Galacs/s6tm-detect-psu-1/s6tm-detect-psu-1.kicad_pcb

## KiCad design s6tm-detect-psu-1.kicad_pcb (2026-09-20)

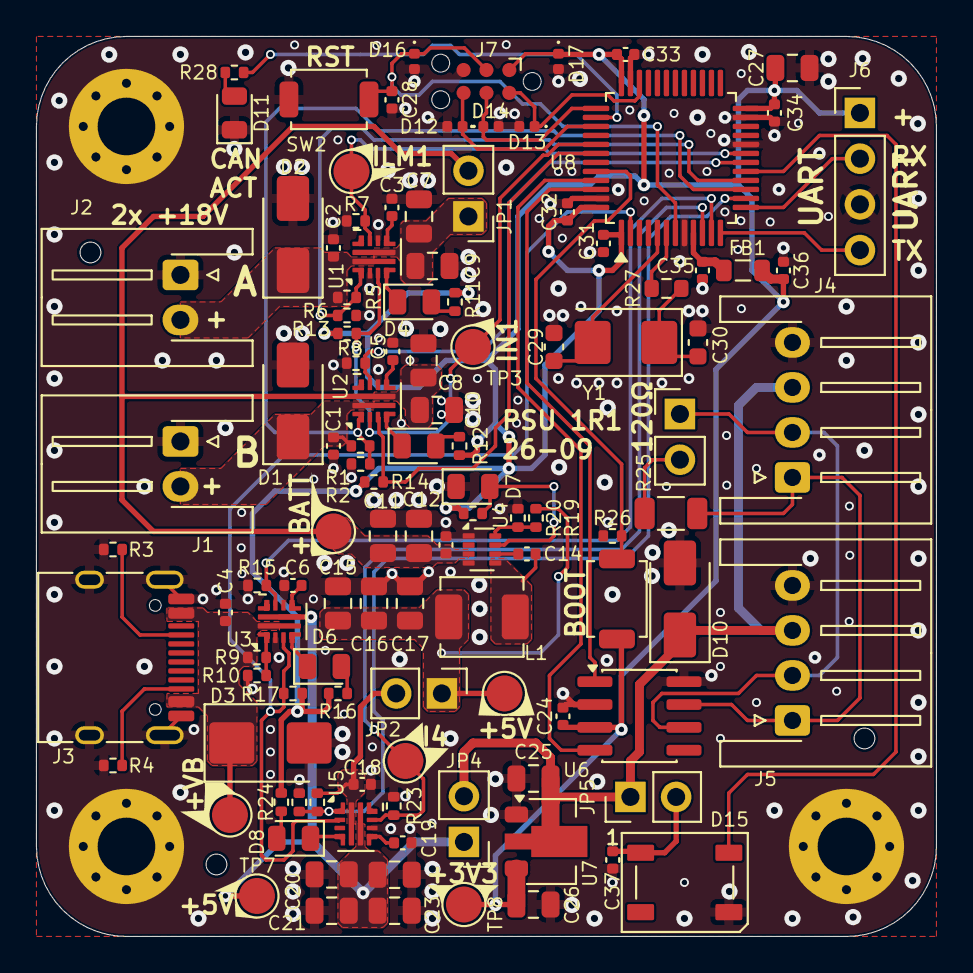
[picture p1: board s6tm-detect-psu-1.kicad_pcb from above]

Board: 4 copper layers, 50.0 x 50.0 mm, 120 parts (0 on the bottom side), 56 nets.

Parts:
C1, C2, C4, C18, C35, C36, C37: 1u; C_0402_1005Metric
C3, C5, C6, C19: 1n; C_0402_1005Metric
C7, C8, C9, C10, C11, C12, C15, C16, C17, C20, C21, C22, C23, C25, C26, C27: 10u; C_0805_2012Metric
C13, C14, C24, C28, C31, C32, C33, C34: 0u1; C_0402_1005Metric
C29, C30: 20p; C_0603_1608Metric
D1, D2, D10: SMBJ6.0CA; D_SMA
D3: SMBJ6.0CA; D_SMB
D4, D5, D6, D8: GREEN; LED_0805_2012Metric
D7: RED; LED_0805_2012Metric
D11: YELLOW; LED_0805_2012Metric
D12, D13, D14, D16, D17: H5VU10U; Diode_DFN1006
D15: WS2812B; LED_WS2812B_PLCC4_5.0x5.0mm_P3.2mm
FB1: 600Ω@100M; L_0805_2012Metric
H1, H2, H3: MountingHole; ToolingHole_1.152mm
H6, H7, H8: MountingHole_Pad; MountingHole_3.2mm_M3_Pad_Via
J1, J2: Conn_01x02; JST_XH_S2B-XH-A-1_1x02_P2.50mm_Horizontal
J3: USB_C_Receptacle_USB2.0_14P; USB_C_Receptacle_HRO_TYPE-C-31-M-12
J4, J5: Conn_01x04; JST_XH_S4B-XH-A-1_1x04_P2.50mm_Horizontal
J6: Conn_01x04_Pin; PinHeader_1x04_P2.54mm_Vertical
J7: TC2030; Tag-Connect_TC2030-IDC-NL_2x03_P1.27mm_Vertical
JP1, JP2, JP3, JP4, JP5: Jumper_2_Small_Bridged; PinHeader_1x02_P2.54mm_Vertical
L1: 3u3; L_Sunlord_MWSA0402S
R1, R5, R9, R13, R14, R17, R20, R21, R26: 10k; R_0402_1005Metric
R2, R6, R15, R23: 1k; R_0402_1005Metric
R3, R4, R11, R12, R16, R18, R24, R28: 5k1; R_0402_1005Metric
R7, R8, R10, R22: 3k3; R_0402_1005Metric
R19: 52k3; R_0402_1005Metric
R25: 120; R_1206_3216Metric
R27: 560; R_0603_1608Metric
SW1, SW2: SW_Push; SW_SPST_TS-1088-xR020
TP1, TP2, TP3, TP4, TP5, TP6, TP7, TP8: TestPoint; TestPoint_Pad_D2.0mm
U1, U2, U3, U5: TPS259470x; Texas_RPW0010A_VQFN-HR-10_2x2mm_P0.5mm
U4: TPS62933; SOT-583-8
U6: SN65HVD230; SOIC-8_3.9x4.9mm_P1.27mm
U7: HT753-1; SOT-89-3
U8: STM32F103C8Tx; LQFP-48_7x7mm_P0.5mm
Y1: 8M; Crystal_SMD_5032-2Pin_5.0x3.2mm

Connections:
5_V: R21.1, R22.2, U5.1 (EN/UVLO), U8.14 (ADC1_IN4)
+3V3: C24.1, C26.1, C27.1, C31.1, C32.1, C33.1, C34.1, C36.1, D17.1 (K), FB1.2, J6.1, J7.1 (VCC), R11.2, R12.2, R13.1, R14.1, R16.2, R17.1, R18.1, R24.2, SW1.1, TP8.1 (1_1), U6.3 (VCC), U7.3 (VOUT), U8.1 (VBAT), U8.24 (VDD), U8.36 (VDD), U8.48 (VDD)
+5V: C20.1, C21.1, C22.1, C23.1, C25.1, C37.2, D10.1 (A1), D15.1 (VDD), J4.3, J5.3, JP4.1 (A), JP4.2 (B), JP5.1 (A), JP5.2 (B), TP7.1 (1_1), U3.6 (OUT), U5.6 (OUT), U7.2 (VIN)
+5V_SMPS: C15.1, C16.1, C17.1, C18.2, JP2.1 (A), JP2.2 (B), L1.2, R19.2, R21.2, TP5.1 (1_1), U5.5 (IN)
+BATT: C7.1, C8.1, C9.1, C10.1, C11.1, C12.1, C13.1, JP1.1 (A), JP1.2 (B), TP4.1 (1_1), U1.6 (OUT), U2.6 (OUT), U4.3 (VIN)
+Vbus: C4.2, D3.1 (A1), J3.A4 (VBUS), J3.A9 (VBUS), J3.B4 (VBUS), J3.B9 (VBUS), R9.2, TP1.1 (1_1), U3.5 (IN)
/Logic/BOOT: R26.2, SW1.2, U8.44 (BOOT0)
/Logic/CANH: J4.1, J5.1, R25.1, U6.7 (CANH)
/Logic/CANL: J4.2, J5.2, JP3.1 (A), U6.6 (CANL)
/Logic/CAN_RX: U6.4 (R), U8.45 (CAN_RX)
/Logic/CAN_TX: U6.1 (D), U8.46 (CAN_TX)
/Logic/NRST: C28.1, D16.1 (K), J7.3 (~RESET), SW2.2, U8.7 (NRST)
/Logic/RGB: D15.4 (DIN), U8.17 (PA7)
/Logic/SWCLK: D14.1 (K), J7.4 (SWCLK), U8.37 (SWCLK)
/Logic/SWDIO: D13.1 (K), J7.2 (SWDIO), U8.34 (SWDIO)
/Logic/SWO: D12.1 (K), J7.6 (SWO), U8.39 (PB3)
/Logic/U0RXD: J6.2, U8.13 (USART2_RX)
/Logic/U0TXD: J6.4, U8.12 (USART2_TX)
/Logic/XTAL_I: C29.1, U8.5 (RCC_OSC_IN), Y1.2
/Logic/XTAL_O: R27.2, U8.6 (RCC_OSC_OUT)
/Logic/XTAL_RO: C30.1, R27.1, Y1.1
BATT1_V: R5.1, R6.2, U1.1 (EN/UVLO), U8.16 (ADC1_IN6)
BATT2_V: R1.1, R2.2, U2.1 (EN/UVLO), U8.15 (ADC1_IN5)
GND: C1.1, C2.1, C3.2, C4.1, C5.2, C6.2, C7.2, C8.2, C9.2, C10.2, C11.2, C12.2, C13.2, C15.2, C16.2, C17.2, C18.1, C19.2, C20.2, C21.2, C22.2, C23.2, C24.2, C25.2, C26.2, C27.2, C28.2, C29.2, C30.2, C31.2, C32.2, C33.2, C34.2, C35.2, C36.2, C37.1, D1.2 (A2), D2.2 (A2), D3.2 (A2), D7.1 (K), D10.2 (A2), D11.1 (K), D12.2 (A), D13.2 (A), D14.2 (A), D15.3 (VSS), D16.2 (A), D17.2 (A), H6.1 (1_1), H7.1 (1_1), H8.1 (1_1), J1.1, J2.1, J3.A1 (GND), J3.A12 (GND), J3.B1 (GND), J3.B12 (GND), J3.SH (SHIELD), J4.4, J5.4, J6.3, J7.5 (GND), R2.1, R3.1, R4.1, R6.1, R7.2, R8.2, R10.1, R15.2, R20.1, R22.1, R23.2, R26.1, SW2.1, U1.2 (OVLO), U1.8 (GND), U2.8 (GND), U3.2 (OVLO), U3.8 (GND), U4.1 (RT), U4.4 (GND), U5.8 (GND), U6.2 (GND), U6.8 (Rs), U7.1 (GND), U8.8 (VSSA), U8.20 (PB2), U8.23 (VSS), U8.35 (VSS), U8.47 (VSS)
ILM1: R7.1, TP2.1 (1_1), U1.9 (ILM), U8.19 (ADC1_IN9)
ILM2: R8.1, U2.9 (ILM), U8.18 (ADC1_IN8)
ILM3: R15.1, U3.9 (ILM), U8.11 (ADC1_IN1)
ILM4: R23.1, TP6.1 (1_1), U5.9 (ILM), U8.10 (ADC1_IN0)
IN1: R13.2, TP3.1 (1_1), U1.3 (AUXOFF), U2.2 (OVLO), U8.41 (PB5)
IN2: R14.2, U2.3 (AUXOFF), U8.42 (PB6)
IN3: R17.2, U3.3 (AUXOFF), U5.2 (OVLO), U8.2 (PC13)
unnamed: C1.2, D1.1 (A1), J1.2, R1.2, U2.5 (IN)
unnamed: C2.2, D2.1 (A1), J2.2, R5.2, U1.5 (IN)
unnamed: D4.2 (A), R11.1
unnamed: D4.1 (K), U1.4 (~FLT)
unnamed: D5.2 (A), R12.1
unnamed: D5.1 (K), U2.4 (~FLT)
unnamed: D6.2 (A), R16.1
unnamed: D6.1 (K), U3.4 (~FLT)
unnamed: D7.2 (A), R18.2, U4.7 (PG)
unnamed: D8.2 (A), R24.1
unnamed: D8.1 (K), U5.4 (~FLT)
unnamed: D11.2 (A), R28.2
unnamed: J3.A5 (CC1), R3.2
unnamed: J3.B5 (CC2), R4.2
unnamed: JP3.2 (B), R25.2
unnamed: C3.1, U1.7 (DVDT)
unnamed: C5.1, U2.7 (DVDT)
unnamed: C6.1, U3.7 (DVDT)
unnamed: R9.1, R10.2, U3.1 (EN/UVLO)
unnamed: C14.2, U4.6 (BST)
unnamed: R19.1, R20.2, U4.8 (FB)
unnamed: C14.1, L1.1, U4.5 (SW)
unnamed: C19.1, U5.7 (DVDT)
unnamed: R28.1, U8.38 (PA15)
unnamed: C35.1, FB1.1, U8.9 (VDDA)
