Galacs/s6tm-detect-psu-1/(commit log)

2026-09-13 schem: add stm32f103c8 mcu
    [s6tm-detect-psu-1.kicad_sch]
2026-09-13 schem: add can transceiver and connectors
    [s6tm-detect-psu-1.kicad_sch]
2026-09-13 schem: add boot/rst buttons
    [s6tm-detect-psu-1.kicad_sch]
2026-09-13 schem: add HT753-1 3V3 LDO
    [s6tm-detect-psu-1.kicad_sch]
2026-09-13 schem: add tag connect prog header
    [s6tm-detect-psu-1.kicad_sch]
2026-09-13 schem: add +5V pwr
    [s6tm-detect-psu-1.kicad_sch]
2026-09-14 schem: add TPS62933P VBAT SMPS
    [s6tm-detect-psu-1.kicad_sch]
2026-09-14 schem: add prio 2x 20v battery efuses
    [18v-efuse.kicad_sch, s6tm-detect-psu-1.kicad_sch]
2026-09-14 schem: add usb pwr input with TPS259470x 5V 3A efuse
    [18v-efuse.kicad_sch]
2026-09-14 schem: add power protection diodes
    [18v-efuse.kicad_sch]
2026-09-14 schem: move smps to second page
    [18v-efuse.kicad_sch, s6tm-detect-psu-1.kicad_sch]
2026-09-15 schem: add +5v efuses
    [18v-efuse.kicad_sch]
2026-09-15 schem: switch main page to logic and power to front
    [18v-efuse.kicad_sch, logic.kicad_sch, s6tm-detect-psu-1.kicad_sch]
2026-09-15 schem: add efuses net labels
    [s6tm-detect-psu-1.kicad_sch]
2026-09-15 schem: update 6n conn tvs diodes
    [logic.kicad_sch, s6tm-detect-psu-1.kicad_sch]
2026-09-15 schem: add rgb status led
    [logic.kicad_sch]
2026-09-15 schem: add voltage probing pins
    [s6tm-detect-psu-1.kicad_sch]
2026-09-15 schem: add +5v bulk output caps
    [s6tm-detect-psu-1.kicad_sch]
2026-09-15 schem: connect efuses to mcu
    [logic.kicad_sch, s6tm-detect-psu-1.kicad_sch]
2026-09-15 schem: add test points
    [logic.kicad_sch, s6tm-detect-psu-1.kicad_sch]
2026-09-15 schem: add current measure jumpers
    [logic.kicad_sch, s6tm-detect-psu-1.kicad_sch]
2026-09-15 schem: add rgb decoupling cap
    [logic.kicad_sch]
2026-09-15 schem: add no connects
    [logic.kicad_sch]
2026-09-15 schem: run and fix ERC
    [logic.kicad_sch]
2026-09-16 schem: add missing parts to BOM
    [logic.kicad_sch, s6tm-detect-psu-1.kicad_sch]
2026-09-16 schem: add title
    [s6tm-detect-psu-1.kicad_sch]
2026-09-16 schem: renummber
    [logic.kicad_sch, s6tm-detect-psu-1.kicad_sch]
2026-09-16 pcb: import jlc 4 layer stackup
    [s6tm-detect-psu-1.kicad_pcb]
2026-09-16 schem: update 2x 2ipn xh header footprint
    [s6tm-detect-psu-1.kicad_sch]
2026-09-16 pcb: import parts from schem
    [s6tm-detect-psu-1.kicad_pcb]
2026-09-16 pcb: add missing 3d models
    [s6tm-detect-psu-1.kicad_pcb]
2026-09-16 pcb: initial sectionning
    [s6tm-detect-psu-1.kicad_pcb]
2026-09-16 schem: update some 10u footprints
    [s6tm-detect-psu-1.kicad_pcb, s6tm-detect-psu-1.kicad_sch]
2026-09-16 pcb: add efuse 1 layout
    [s6tm-detect-psu-1.kicad_pcb]
2026-09-16 pcb: add efuse routing
    [s6tm-detect-psu-1.kicad_pcb]
2026-09-16 pcb: add ldo layout
    [s6tm-detect-psu-1.kicad_pcb]
2026-09-16 pcb: add can layout
    [logic.kicad_sch, s6tm-detect-psu-1.kicad_pcb]
2026-09-16 pcb: add smps layout
    [s6tm-detect-psu-1.kicad_pcb, s6tm-detect-psu-1.kicad_sch]
2026-09-16 schem/pcb: add mouting and tooling holes
    [s6tm-detect-psu-1.kicad_pcb, s6tm-detect-psu-1.kicad_sch]
2026-09-16 pcb: add board outine
    [s6tm-detect-psu-1.kicad_pcb]
2026-09-16 pcb: initial placement
    [s6tm-detect-psu-1.kicad_pcb]
2026-09-16 pcb: add rounded corners
    [s6tm-detect-psu-1.kicad_pcb]
2026-09-16 schem: remove fiducials
    [s6tm-detect-psu-1.kicad_sch]
2026-09-16 pcb: add tooling holes placement
    [s6tm-detect-psu-1.kicad_pcb]
2026-09-17 pcb: finish board layout
    [s6tm-detect-psu-1.kicad_pcb, s6tm-detect-psu-1.kicad_sch]
2026-09-17 pcb: add gnd planes
    [s6tm-detect-psu-1.kicad_pcb]
2026-09-17 pcb: add gnd vias
    [s6tm-detect-psu-1.kicad_pcb]
2026-09-17 pcb: add drill/place origin
    [s6tm-detect-psu-1.kicad_pcb]
2026-09-17 pcb: add crystal routing
    [s6tm-detect-psu-1.kicad_pcb]
2026-09-17 pcb: add swd routing
    [s6tm-detect-psu-1.kicad_pcb]
2026-09-17 pcb: add can routing
    [s6tm-detect-psu-1.kicad_pcb]
2026-09-19 pcb: add batt efuses routing
    [s6tm-detect-psu-1.kicad_pcb, s6tm-detect-psu-1.kicad_sch]
2026-09-19 pcb: add +5V efuse routing
    [s6tm-detect-psu-1.kicad_pcb]
2026-09-19 pcb: add v and i routing
    [logic.kicad_sch, s6tm-detect-psu-1.kicad_pcb]
2026-09-19 pcb: add can led routing
    [s6tm-detect-psu-1.kicad_pcb]
2026-09-19 pcb: route efuse signals
    [logic.kicad_sch, s6tm-detect-psu-1.kicad_pcb]
2026-09-19 pcb: route efuse gpios
    [logic.kicad_sch, s6tm-detect-psu-1.kicad_pcb]
2026-09-19 pcb: add smps routing
    [s6tm-detect-psu-1.kicad_pcb]
2026-09-19 pcb: add +batt routing
    [s6tm-detect-psu-1.kicad_pcb]
2026-09-19 pcb: add uart routing
    [s6tm-detect-psu-1.kicad_pcb]
2026-09-19 pcb: finish can routing
    [s6tm-detect-psu-1.kicad_pcb]
2026-09-19 pcb: add rgb routing
    [logic.kicad_sch, s6tm-detect-psu-1.kicad_pcb]
2026-09-19 pcb: add boot/rst routing
    [s6tm-detect-psu-1.kicad_pcb]
2026-09-19 pcb: add +5v pwr routing
    [s6tm-detect-psu-1.kicad_pcb]
2026-09-20 pcb: add +3v3 pwr routing
    [s6tm-detect-psu-1.kicad_pcb]
2026-09-20 pcb: clean traces
    [s6tm-detect-psu-1.kicad_pcb]
2026-09-20 pcb: add stitching vias
    [s6tm-detect-psu-1.kicad_pcb]
2026-09-20 pcb: run and fix DRC
    [s6tm-detect-psu-1.kicad_pcb]
2026-09-20 pcb: remove unused internal pads
    [s6tm-detect-psu-1.kicad_pcb]
2026-09-20 pcb(silk): clean reference designators
    [s6tm-detect-psu-1.kicad_pcb]
2026-09-20 pcb(silk): add usr text
    [s6tm-detect-psu-1.kicad_pcb]
2026-09-20 pcb: add title
    [s6tm-detect-psu-1.kicad_pcb]
2026-09-20 schem: update resistor part number
    [s6tm-detect-psu-1.kicad_sch]
2026-09-20 generate production files
    [bom.csv, designators.csv, positions.csv, s6tm-detect-psu-1.kicad_pcb]
